versioduo/wave/hardware/README.md

# wave
🔊 MIDI Wave Synthesizer with Class-D Amplifier 

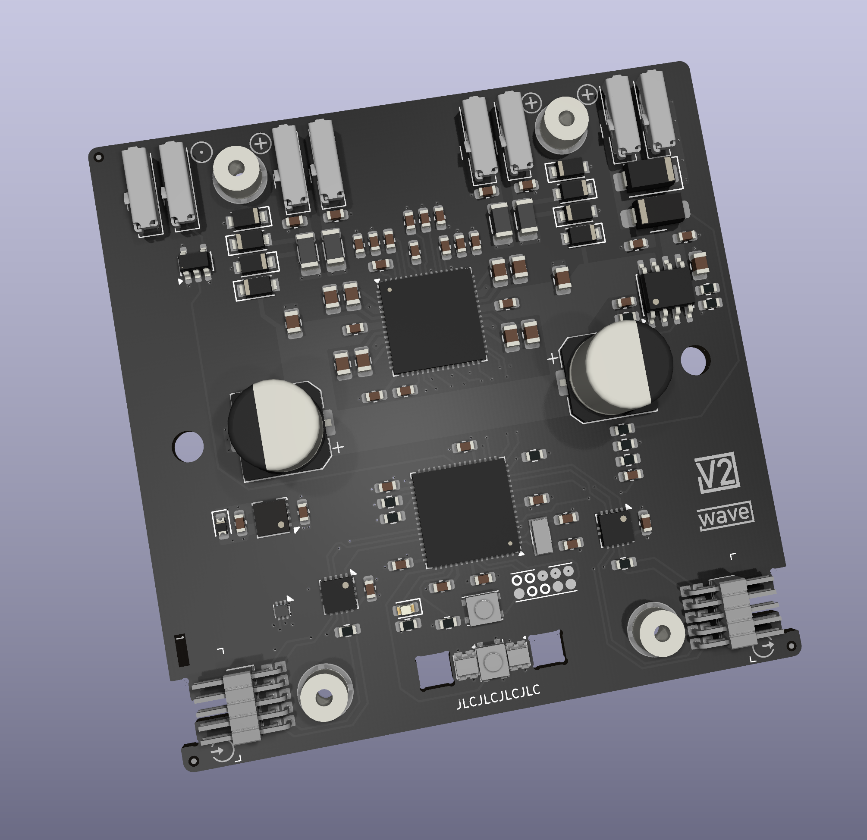
[picture p1: hardware/wave-board.png]
wave


## Schematic
[PDF](wave.pdf)

## Bill Of Materials
[Interactive BOM](https://html-preview.github.io/?url=https://github.com/versioduo/wave/main/hardware/wave-bom.html)

# Copying
Anyone can use this public domain work without having to seek authorisation, no one can ever own it.
