versioduo/wave/hardware/wave.pdf

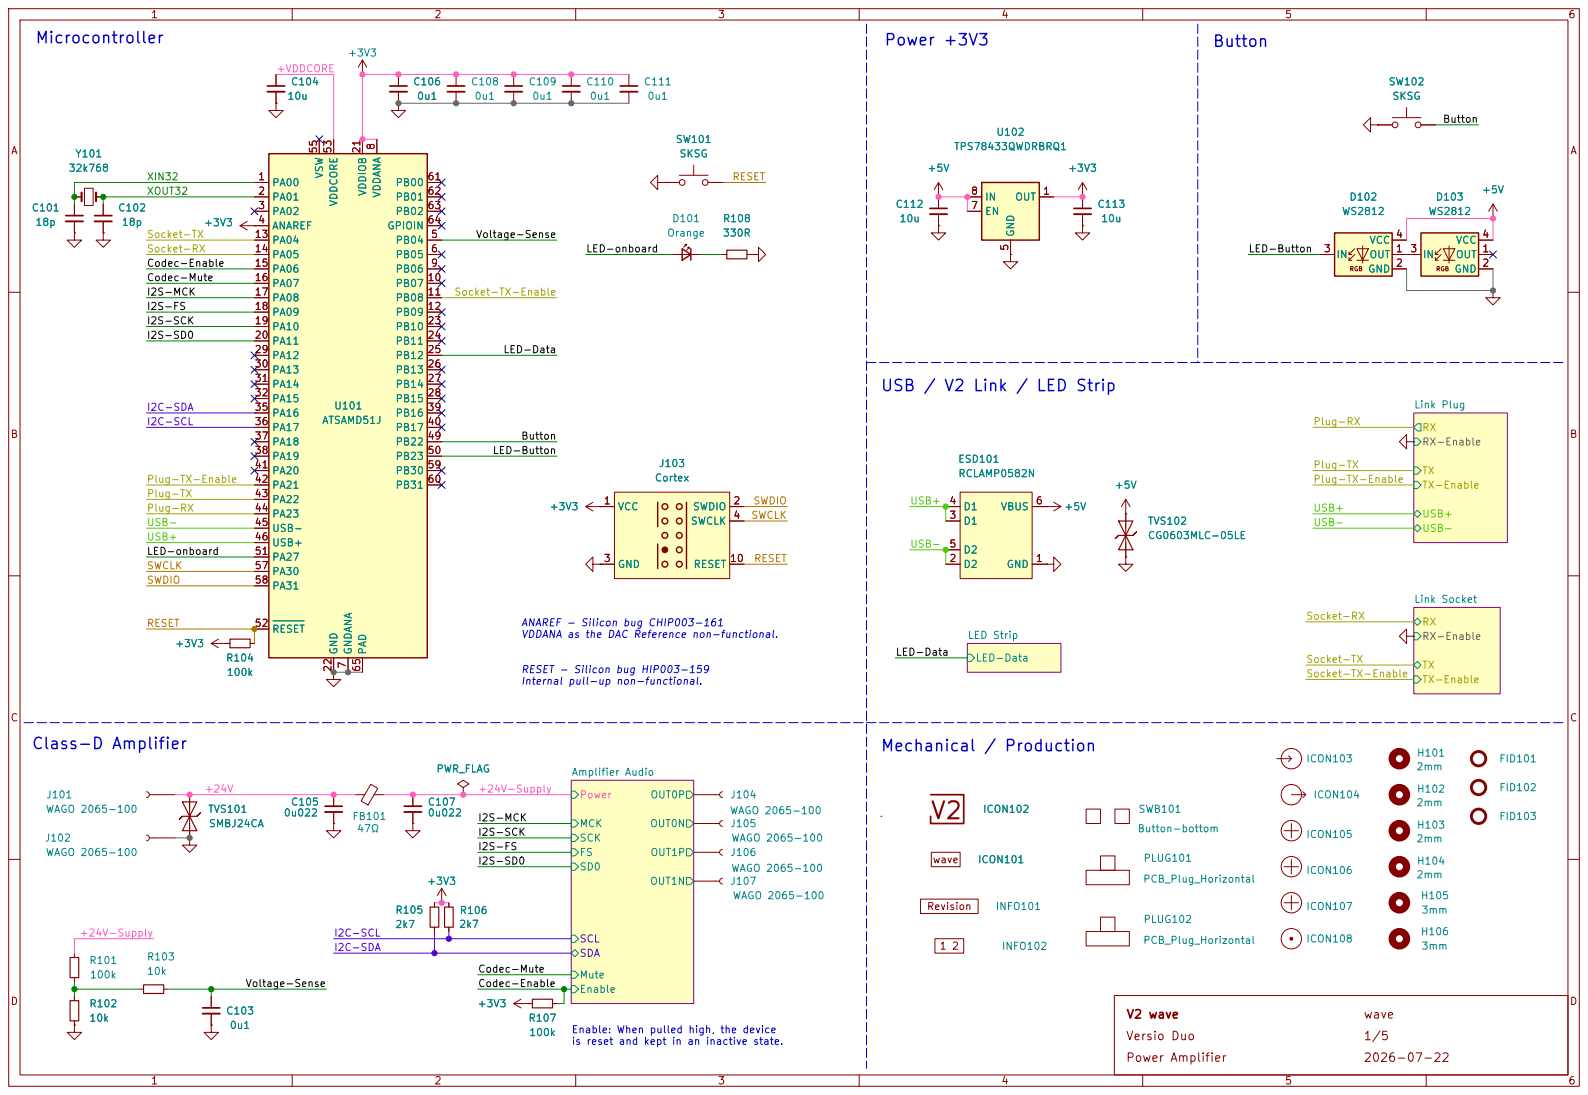
[picture p3: page 1]

VDDANA as the DAC Reference non-functional. Microcontroller

Voltage-Sense Socket-TX-Enable

Socket-RX Codec-Enable

USB / V2 Link / LED Strip

LED-Button Button Plug-TX-Enable

RESET - Silicon bug HIP003-159
Internal pull-up non-functional.

I2S-SCK +24V-Supply
Enable Mute SCL FS

Enable: When pulled high, the device

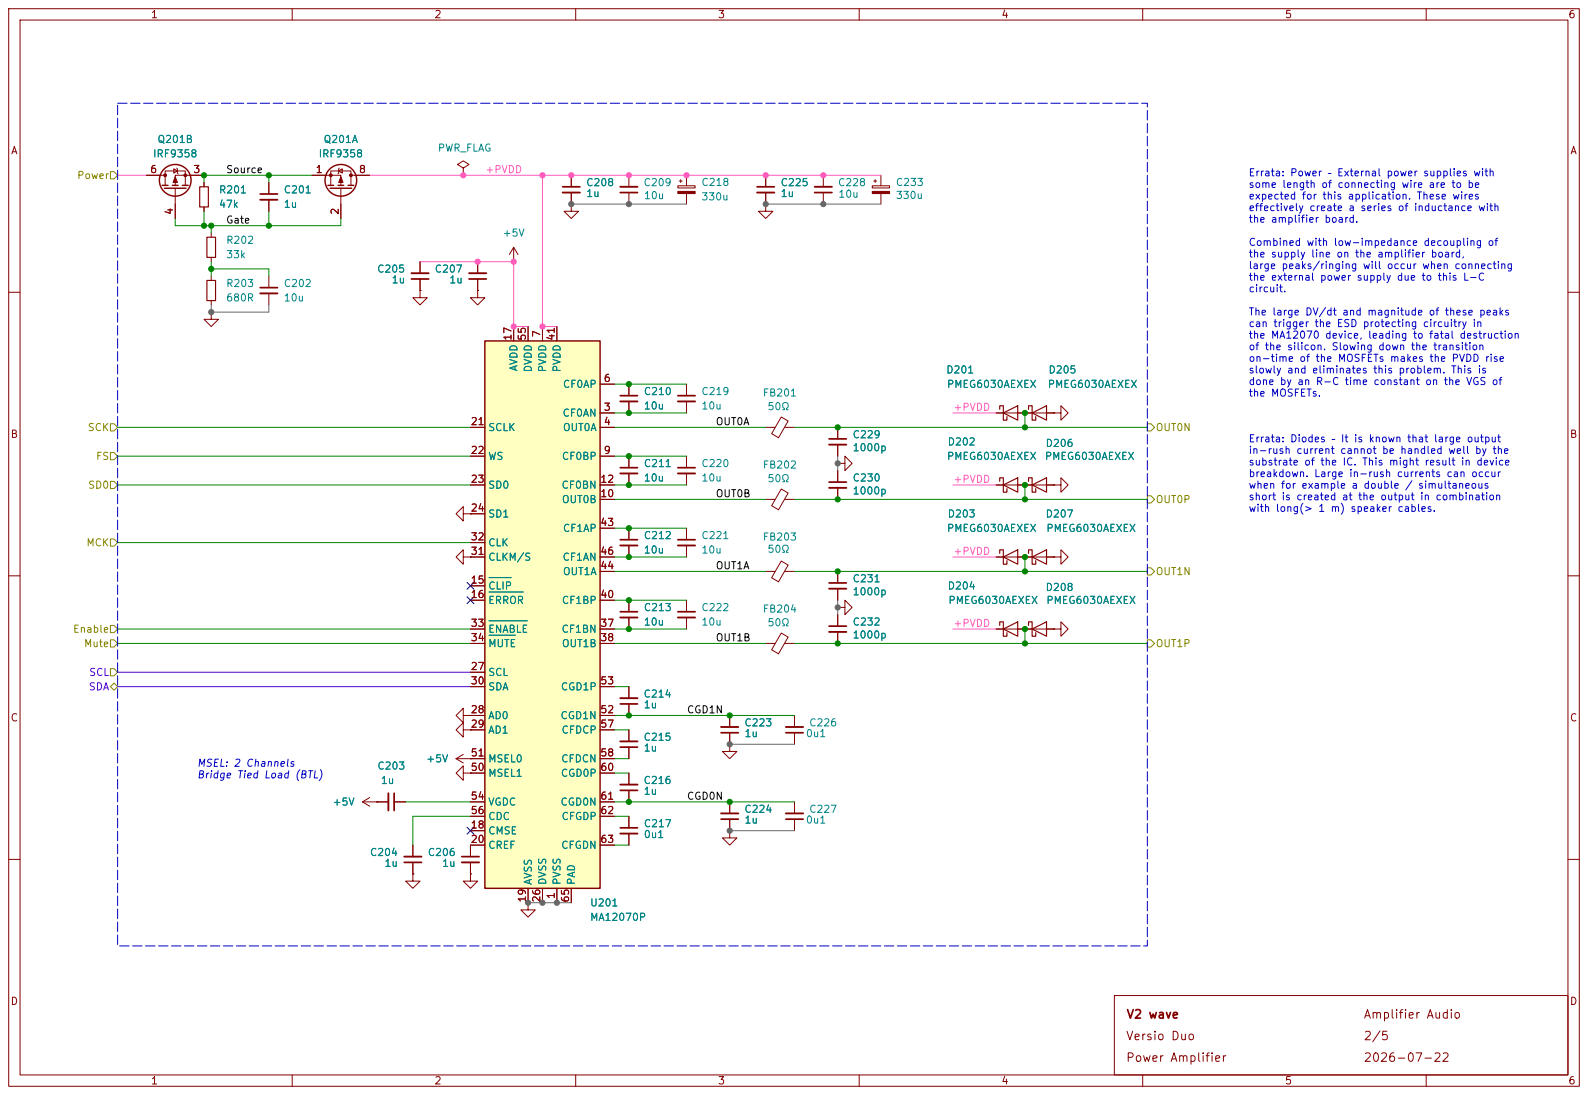
[picture p4: page 2]

Errata: Power – External power supplies with
some length of connecting wire are to be
expected for this application. These wires effectively create a series of inductance with

the amplifier board. Combined with low-impedance decoupling of

the supply line on the amplifier board,
large peaks/ringing will occur when connecting
the external power supply due to this L-C
circuit. The large DV/dt and magnitude of these peaks can trigger the ESD protecting circuitry in

the MA12070 device, leading to fatal destruction
of the silicon. Slowing down the transition
on-time of the MOSFETs makes the PVDD rise
slowly and eliminates this problem. This is done by an R-C time constant on the VGS of

the MOSFETs. Errata: Diodes – It is known that large output

in-rush current cannot be handled well by the
substrate of the IC. This might result in device breakdown. Large in-rush currents can occur when for example a double / simultaneous

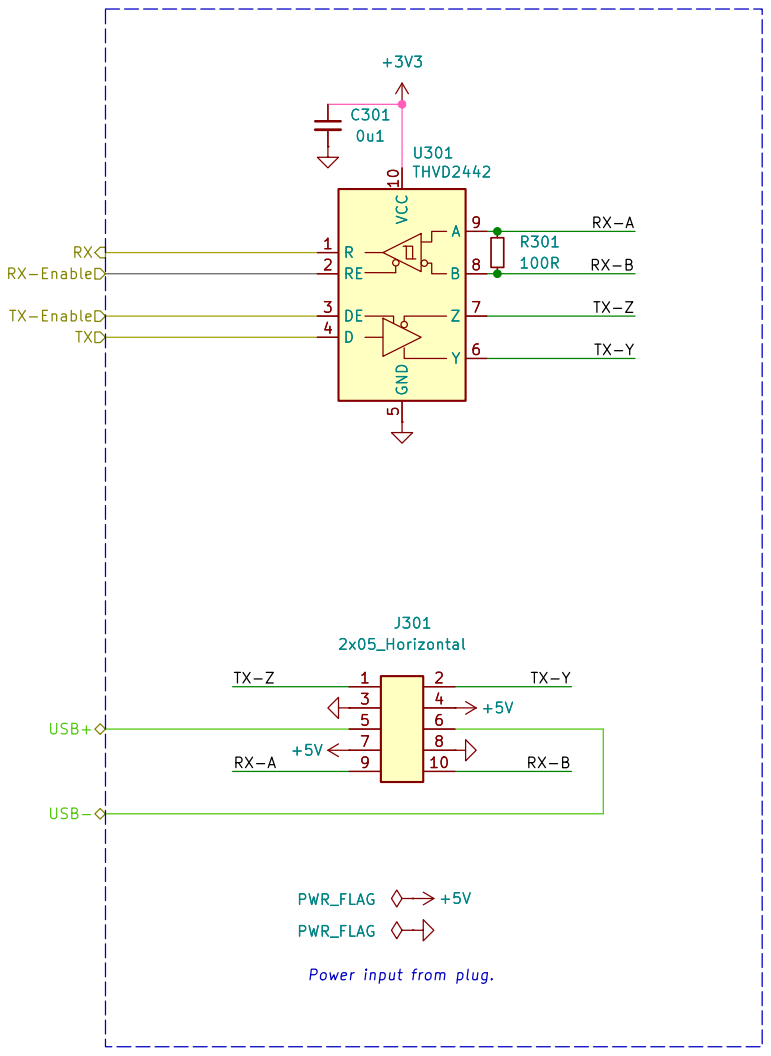
[picture p5: page 3]

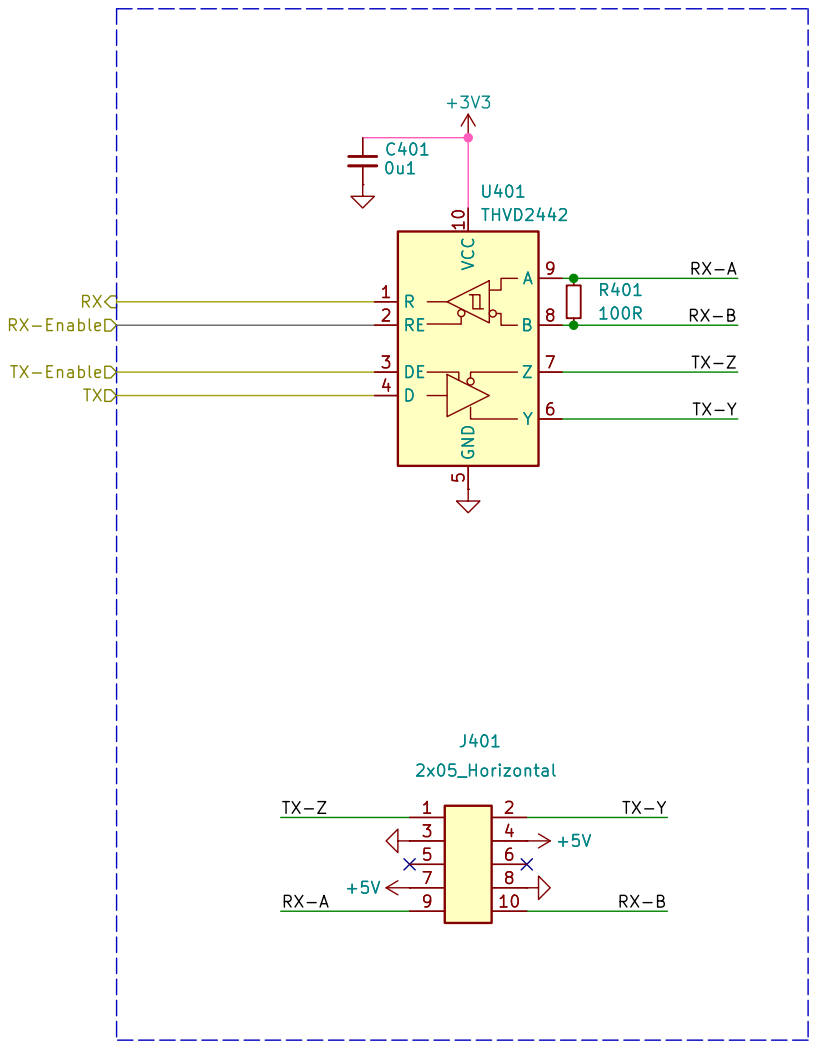
[picture p6: page 4]

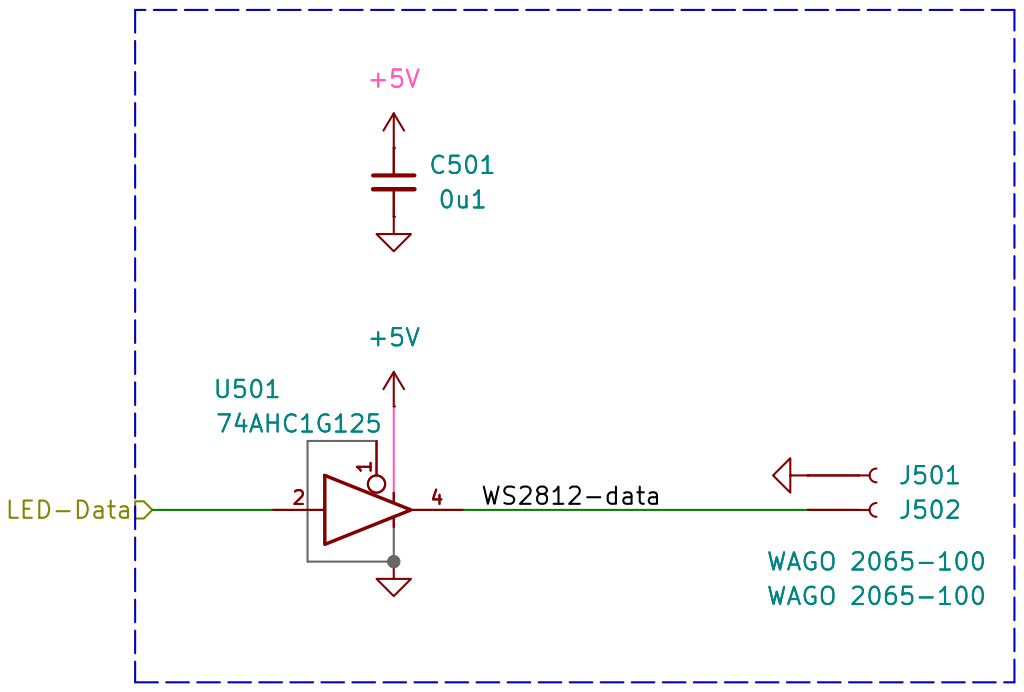
[picture p7: page 5]
