versioduo/wave/hardware/wave.kicad_pcb

## KiCad design hardware/wave.kicad_pcb (2026-07-22)

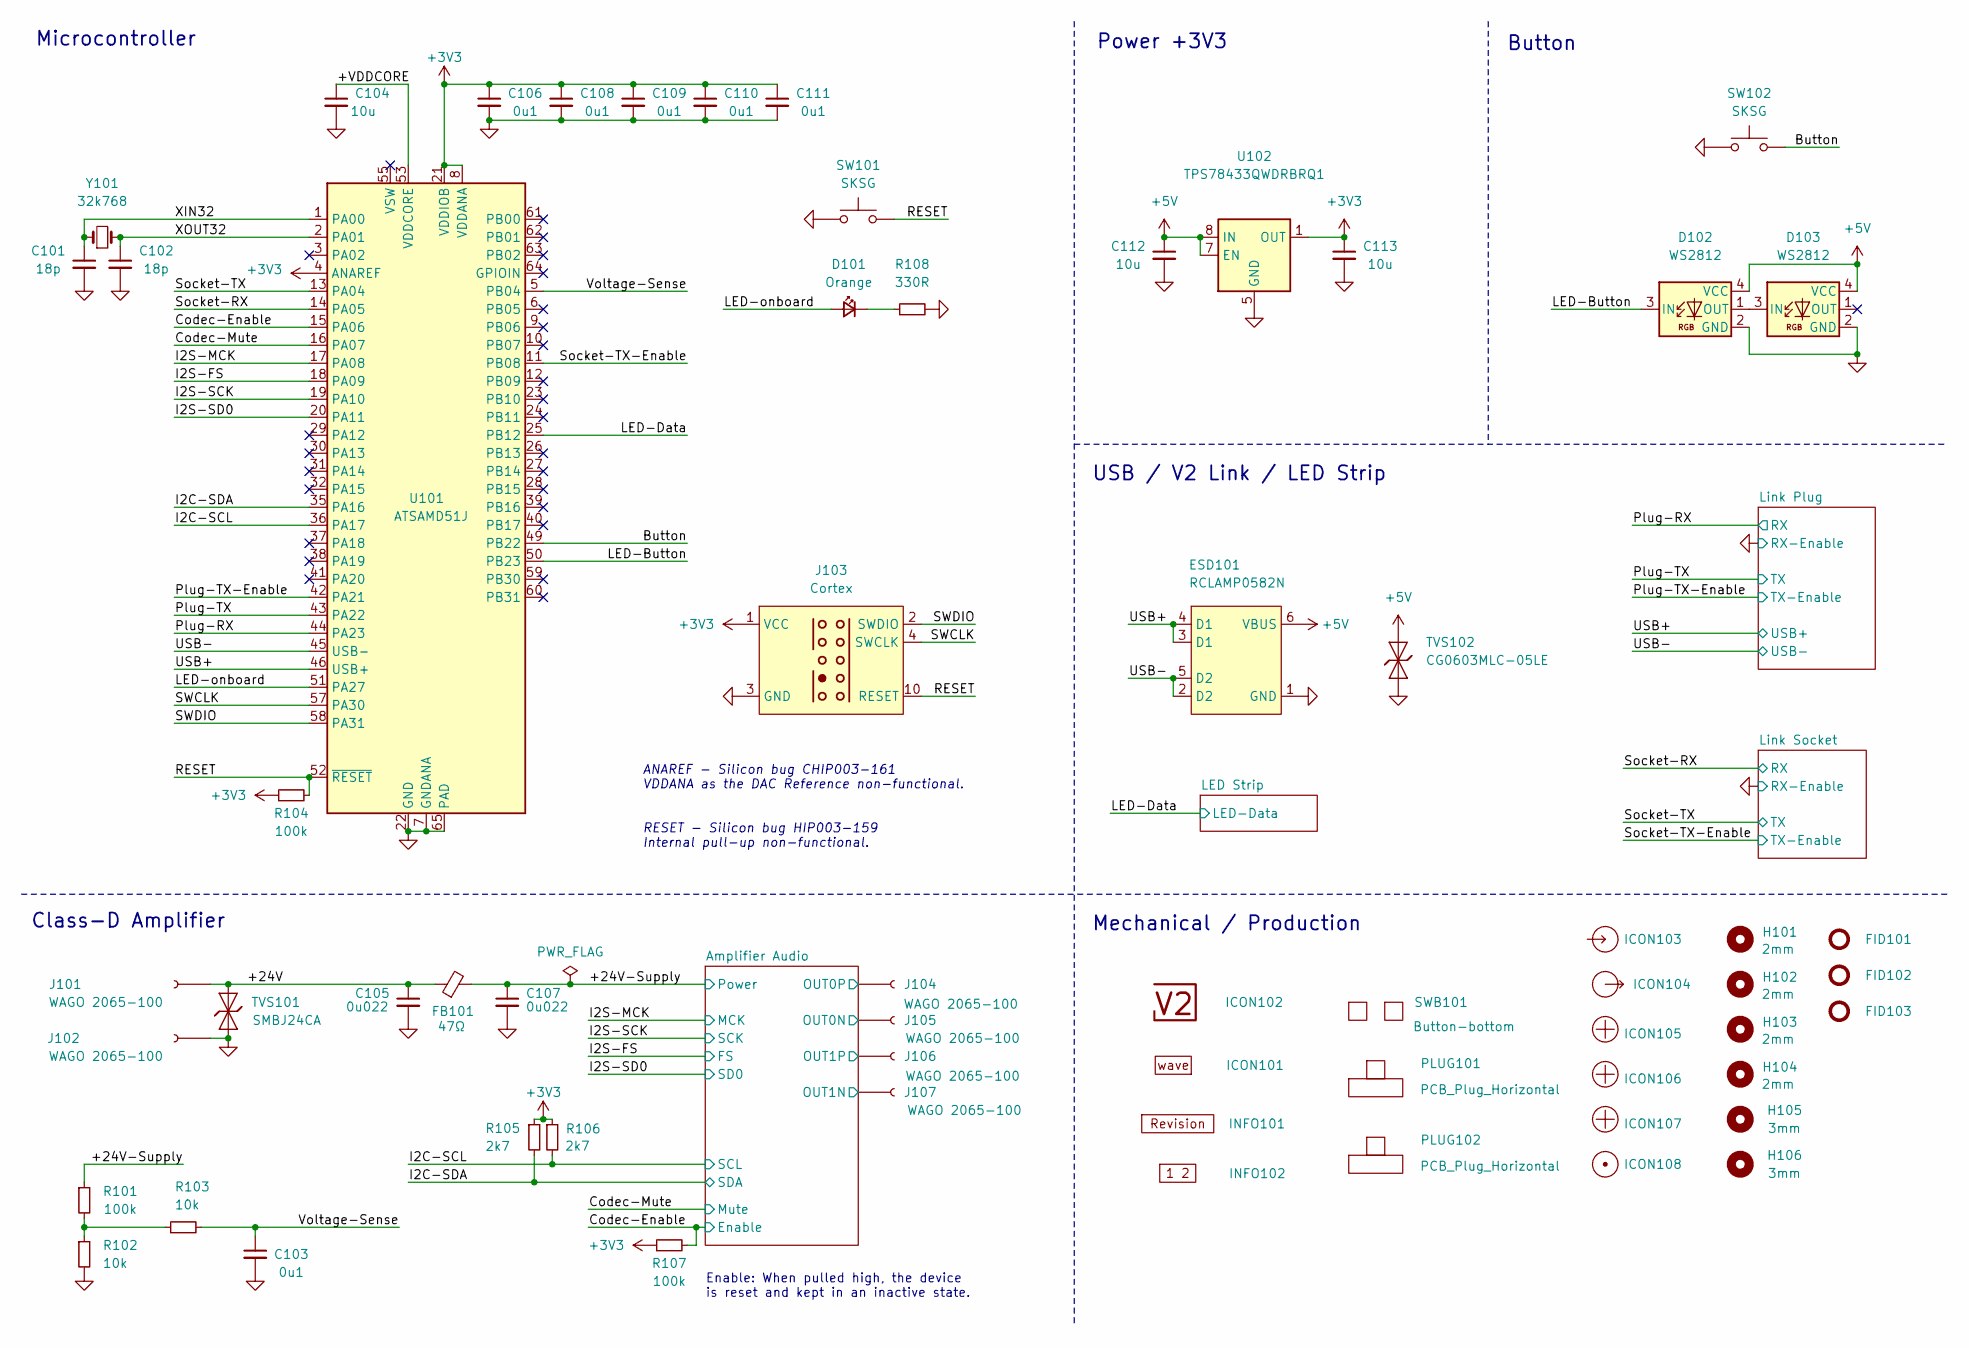
[picture p8: schematic wave.kicad_sch, V2 wave]

Parts:
C101, C102: 18p; C_1608; Rating 50V; Mouser 810-CGA3E2C0G1H180J
C103, C106, C108, C109, C110, C111: 0u1; C_1608; Rating 50V; Mouser 810-CGA3E2X7R1H104MA
C104: 10u; C_1608; Rating 10V; Mouser 810-C1608X6S1A106M
C105, C107: 0u022; C_1608; Rating 50V; Mouser 603-CC603KPX7R9BB223
C112, C113: 10u; C_2012; Rating 25V; Mouser 810-C2012X5R1E106K
D101: Orange; LED_1608; Rating 605nm; Mouser 755-SML-D12D1WT86
D102, D103: WS2812; WS2812-2020; Rating 15mA; LCSC C965555
ESD101: RCLAMP0582N; SLP1210N6; Rating 20kV; Mouser 947-RCLAMP0582N.TCT
FB101: 47Ω; L_3.1x5.1; Rating 5A; Mouser 623-2743019447LF
FID101, FID102, FID103: Fiducial_Paste; Fiducial_0.5mm_Mask1mm_Paste
H101, H102, H103, H104: 2mm; MountingHole_2mm
H105, H106: 3mm; MountingHole_3mm
ICON101: Board_wave; Board_wave_Small
ICON102: V2-logo; Logo_Small
ICON103: Arrow_In
ICON104: Arrow_Out
ICON105, ICON106, ICON107: Plus; Plus_Small
ICON108: Dot; Dot_Small
INFO101: Revision
INFO102: Layer_Numbers-4
J101, J102, J104, J105, J106, J107: WAGO 2065-100; 2065-100; Rating 9A
J103: Cortex
PLUG101, PLUG102: PCB_Plug_Horizontal
R101, R104, R107: 100k; R_1608; Rating 100mW; Mouser 71-CRCW0603100KFKEAC
R102, R103: 10k; R_1608; Rating 100mW; Mouser 71-CRCW060310K0FKEAC
R105, R106: 2k7; R_1608; Rating 100mW; Mouser 71-CRCW06032K70FKEAC
R108: 330R; R_1608; Rating 100mW; Mouser 71-CRCW0603330RFKEAC
SW101, SW102: SKSG; Rating 1.6N; Mouser 688-SKSGACE010
SWB101: Button-bottom; PCB_Button-bottom
TVS101: SMBJ24CA; D_SMB; Rating 24V; Mouser 652-SMBJ24CA-Q
TVS102: CG0603MLC-05LE; D_1608; Rating 5V; Mouser 652-CG0603MLC-05LE
U101: ATSAMD51J; QFN-64-1EP_9x9mm_P0.5mm_EP4.8x4.8mm_ThermalVias; Rating Cortex-M4F; Mouser 556-ATSAMD51J19AMU
U102: TPS78433QWDRBRQ1; VSON-8-1_3x3mm_P0.65_EP1.65x2.4mm; Rating 300mA; Mouser 595-TPS78433QWDRBRQ1
Y101: 32k768; Crystal_SMD_3215-2Pin_3.2x1.5mm; Rating 10ppm; Mouser 815-ABS0716632.768KT

Connections:
+3V3: C106.1, C108.1, C109.1, C110.1, C111.1, C113.1, J103.1 (VCC), R104.1, R105.1, R106.1, R107.1, U101.4 (ANAREF), U101.8 (VDDANA), U101.21 (VDDIOB), U101.34 (VDDIO), U101.48 (VDDIO), U101.56 (VDDIO), U102.1 (OUT); also elsewhere on the board
+5V: C112.1, D102.4 (VCC), D103.4 (VCC), ESD101.6 (VBUS), TVS102.2 (A), U102.7 (EN), U102.8 (IN); also elsewhere on the board
/+24V: C105.1, FB101.1, J101.1, TVS101.2 (A)
/+24V-Supply: C107.1, FB101.2, R101.1; also elsewhere on the board
/+VDDCORE: C104.1, U101.53 (VDDCORE)
/Amplifier Audio/OUT0N: J105.1; also elsewhere on the board
/Amplifier Audio/OUT0P: J104.1; also elsewhere on the board
/Amplifier Audio/OUT1N: J107.1; also elsewhere on the board
/Amplifier Audio/OUT1P: J106.1; also elsewhere on the board
/Button: SW102.2, U101.49 (PB22)
/Codec-Enable: R107.2, U101.15 (PA06); also elsewhere on the board
/Codec-Mute: U101.16 (PA07); also elsewhere on the board
/I2C-SCL: R106.2, U101.36 (PA17); also elsewhere on the board
/I2C-SDA: R105.2, U101.35 (PA16); also elsewhere on the board
/I2S-FS: U101.18 (PA09); also elsewhere on the board
/I2S-MCK: U101.17 (PA08); also elsewhere on the board
/I2S-SCK: U101.19 (PA10); also elsewhere on the board
/I2S-SD0: U101.20 (PA11); also elsewhere on the board
/LED-Button: D102.3 (IN), U101.50 (PB23)
/LED-Data: U101.25 (PB12); also elsewhere on the board
/LED-onboard: D101.2 (A), U101.51 (PA27)
/Plug-RX: U101.44 (PA23); also elsewhere on the board
/Plug-TX: U101.43 (PA22); also elsewhere on the board
/Plug-TX-Enable: U101.42 (PA21); also elsewhere on the board
/RESET: J103.10 (RESET), R104.2, SW101.2, U101.52 (~RESET)
/SWCLK: J103.4 (SWCLK), U101.57 (PA30)
/SWDIO: J103.2 (SWDIO), U101.58 (PA31)
/Socket-RX: U101.14 (PA05); also elsewhere on the board
/Socket-TX: U101.13 (PA04); also elsewhere on the board
/Socket-TX-Enable: U101.11 (PB08); also elsewhere on the board
/USB+: ESD101.3 (D1), ESD101.4 (D1), U101.46 (USB+); also elsewhere on the board
/USB-: ESD101.2 (D2), ESD101.5 (D2), U101.45 (USB-); also elsewhere on the board
/Voltage-Sense: C103.1, R103.2, U101.5 (PB04)
/XIN32: C101.1, U101.1 (PA00), Y101.1
/XOUT32: C102.1, U101.2 (PA01), Y101.2
GND: C101.2, C102.2, C103.2, C104.2, C105.2, C106.2, C107.2, C108.2, C109.2, C110.2, C111.2, C112.2, C113.2, D102.2 (GND), D103.2 (GND), ESD101.1 (GND), J102.1, J103.3 (GND), J103.5 (GND), R102.2, R108.2, SW101.1, SW102.1, TVS101.1 (K), TVS102.1 (K), U101.7 (GNDANA), U101.22 (GND), U101.33 (GND), U101.47 (GND), U101.54 (GND), U101.65 (PAD), U102.5 (GND), U102.9 (GND); also elsewhere on the board
unnamed: D101.1 (K), R108.1
unnamed: D102.1 (OUT), D103.3 (IN)
unnamed: R101.2, R102.1, R103.1

Notes on the sheet:
 ANAREF - Silicon bug CHIP003-161 VDDANA as the DAC Reference non-functional.
RESET -  Silicon bug HIP003-159 Internal pull-up non-functional.
Button
USB / V2 Link / LED Strip
Mechanical / Production
Power +3V3
Enable: When pulled high, the device is reset and kept in an inactive state.
Microcontroller
Class-D Amplifier

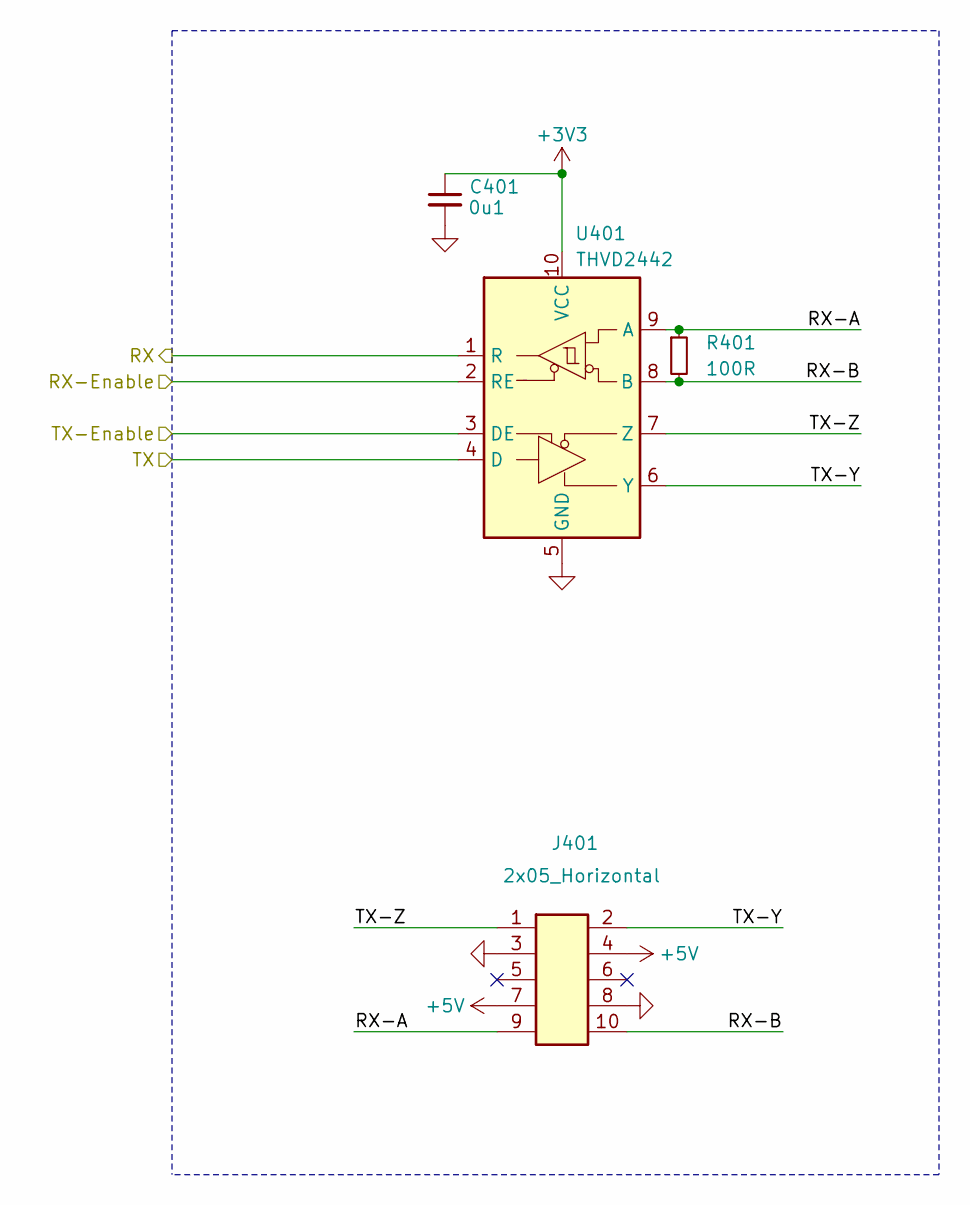
[picture p9: schematic LinkSocket.kicad_sch, V2 wave]

Parts:
C401: 0u1; C_1608; Rating 50V; Mouser 810-CGA3E2X7R1H104MA
J401: 2x05_Horizontal; PinHeader_2x05_P1.27mm_Horizontal; Rating 1A; Mouser 649-200211120001T4LF
R401: 100R; R_1608; Rating 330mW; Mouser 71-CRCW0603100RFKEAH
U401: THVD2442; VSON-10-4-1EP_3x3mm_P0.5mm_EP1.65x2.4mm_ThermalVias; Rating 20Mbps; Mouser 595-THVD2442DRCR

Connections:
+3V3: C401.1, U401.10 (VCC); also elsewhere on the board
+5V: J401.4, J401.7; also elsewhere on the board
/Link Socket/RX-A: J401.9, R401.1, U401.9 (A)
/Link Socket/RX-B: J401.10, R401.2, U401.8 (B)
/Link Socket/TX-Y: J401.2, U401.6 (Y)
/Link Socket/TX-Z: J401.1, U401.7 (Z)
/Socket-RX: U401.1 (R); also elsewhere on the board
/Socket-TX: U401.4 (D); also elsewhere on the board
/Socket-TX-Enable: U401.3 (DE); also elsewhere on the board
GND: C401.2, J401.3, J401.8, U401.2 (RE), U401.5 (GND), U401.11 (GND); also elsewhere on the board

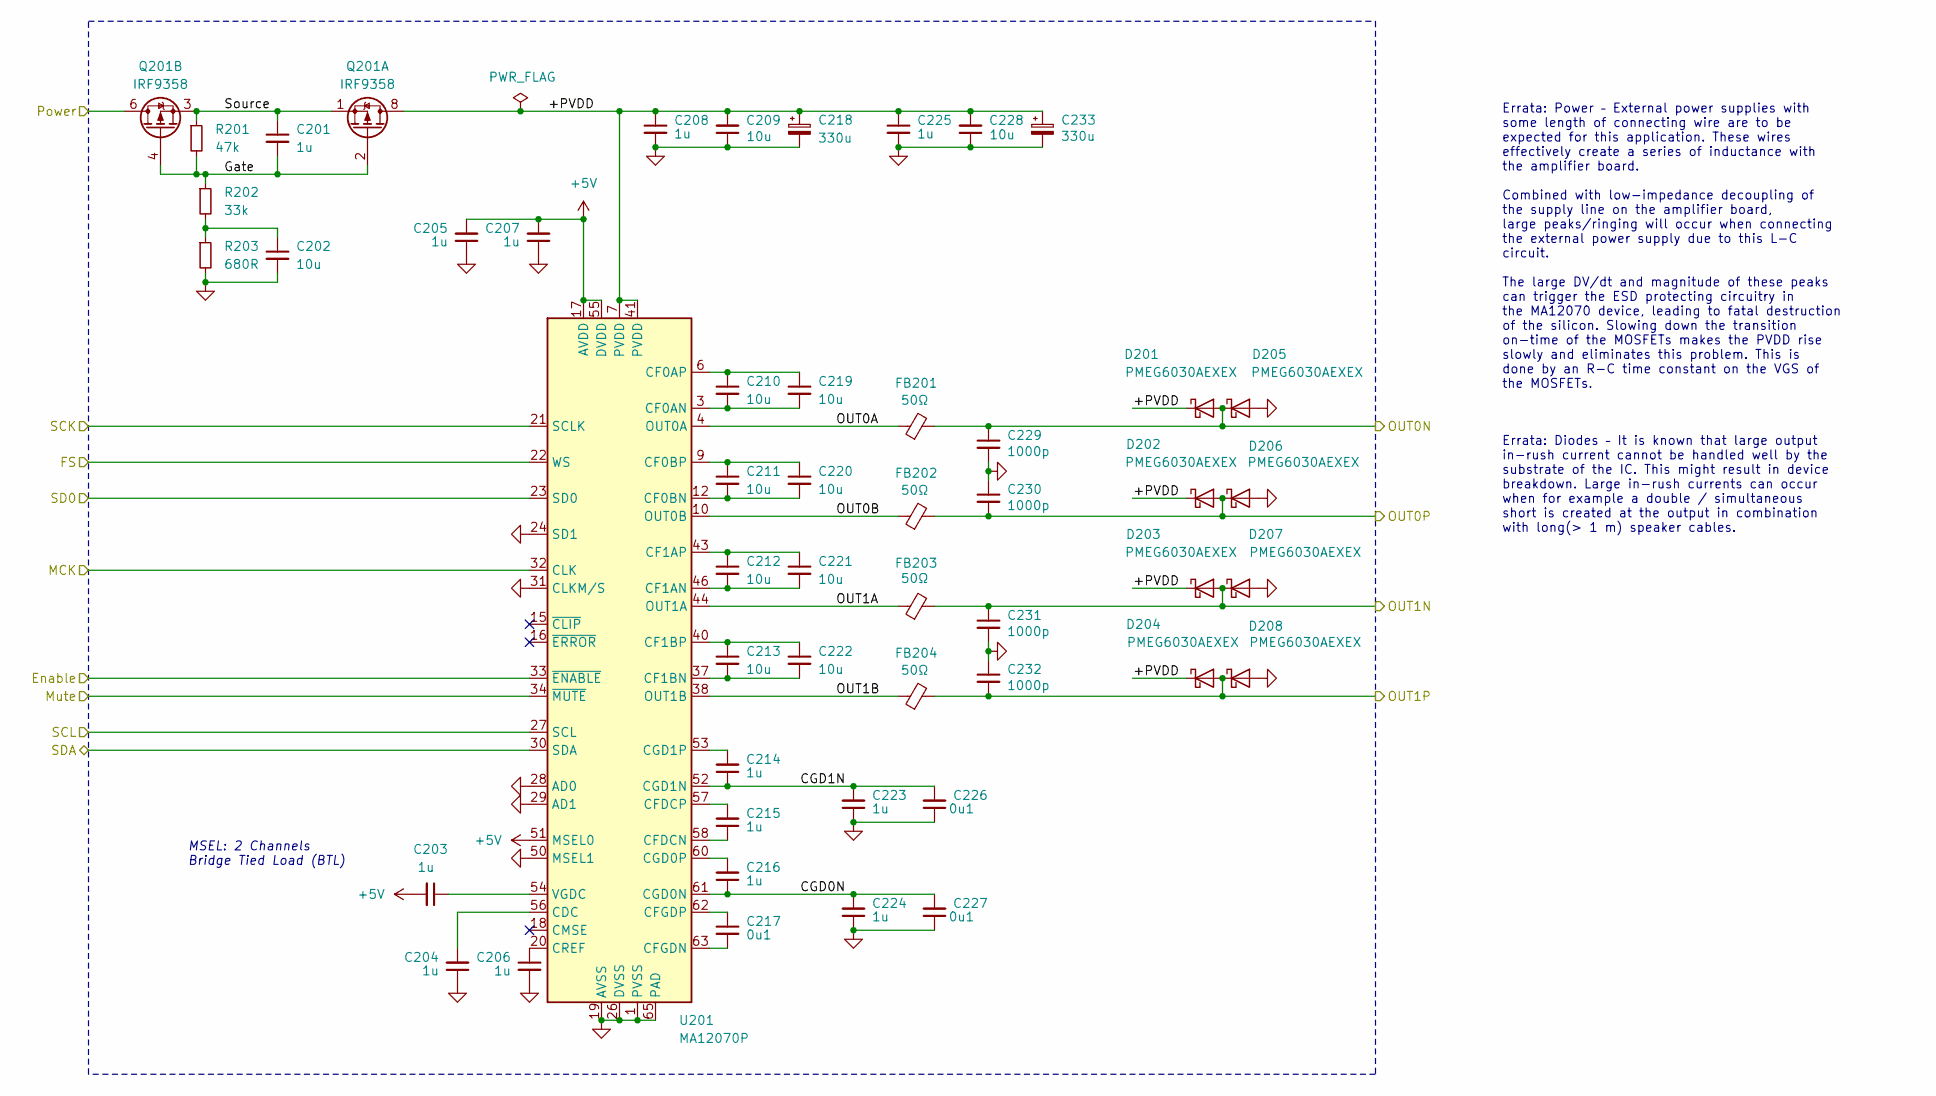
[picture p10: schematic AmplifierAudio.kicad_sch, V2 wave]

Parts:
C201, C203, C204, C205, C206, C207, C208, C214, C215, C216, C223, C224, C225: 1u; C_1608; Rating 50V; Mouser 810-CGA3E3X7R1H105K0
C202, C209, C210, C211, C212, C213, C219, C220, C221, C222, C228: 10u; C_1608; Rating 10V; Mouser 810-C1608X6S1A106M
C217, C226, C227: 0u1; C_1608; Rating 50V; Mouser 810-CGA3E2X7R1H104MA
C218, C233: 330u; CP_Elec_8x10; Rating 35V; Mouser 667-EEE-FT1V331GP
C229, C230, C231, C232: 1000p; C_1608; Rating 50V; Mouser 810-C1608C0G1H102J
D201, D202, D203, D204, D205, D206, D207, D208: PMEG6030AEXEX; D_SOD-123HP; Rating 60V; Mouser 771-PMEG6030AEXEX
FB201, FB202, FB203, FB204: 50Ω; L_1206; Rating 6A; Mouser 623-2512065007Y6
Q201: IRF9358; SOIC-8_3.9x4.9mm_P1.27mm; Rating 30V; Mouser 942-IRF9358TRPBF
R201: 47k; R_1608; Rating 250mW; Mouser 71-RCS060347K0FKEA
R202: 33k; R_1608; Rating 330mW; Mouser 71- 71-CRCW060333K0FKEAH
R203: 680R; R_1608; Rating 250mW; Mouser 71-RCS0603680RFKEA
U201: MA12070P; QFN-64-1EP_9x9mm_P0.5mm_EP6x6mm_ThermalVias; Rating 30W; Mouser 726-MA12070PXUMA1

Connections:
+5V: C203.2, C205.2, C207.2, U201.17 (AVDD), U201.51 (MSEL0), U201.55 (DVDD); also elsewhere on the board
/+24V-Supply: Q201.5 (D2), Q201.6 (D2); also elsewhere on the board
/Amplifier Audio/+PVDD: C208.1, C209.2, C218.1, C225.1, C228.2, C233.1, D201.1 (K), D202.1 (K), D203.1 (K), D204.1 (K), Q201.7 (D1), Q201.8 (D1), U201.7 (PVDD), U201.8 (PVDD), U201.41 (PVDD), U201.42 (PVDD)
/Amplifier Audio/CGD0N: C216.1, C224.2, C227.2, U201.61 (CGD0N)
/Amplifier Audio/CGD1N: C214.1, C223.2, C226.2, U201.52 (CGD1N)
/Amplifier Audio/Gate: C201.2, Q201.2 (G1), Q201.4 (G2), R201.2, R202.1
/Amplifier Audio/OUT0A: FB201.1, U201.4 (OUT0A), U201.5 (OUT0A)
/Amplifier Audio/OUT0B: FB202.1, U201.10 (OUT0B), U201.11 (OUT0B)
/Amplifier Audio/OUT0N: C229.1, D201.2 (A), D205.1 (K), FB201.2; also elsewhere on the board
/Amplifier Audio/OUT0P: C230.2, D202.2 (A), D206.1 (K), FB202.2; also elsewhere on the board
/Amplifier Audio/OUT1A: FB203.1, U201.44 (OUT1A), U201.45 (OUT1A)
/Amplifier Audio/OUT1B: FB204.1, U201.38 (OUT1B), U201.39 (OUT1B)
/Amplifier Audio/OUT1N: C231.1, D203.2 (A), D207.1 (K), FB203.2; also elsewhere on the board
/Amplifier Audio/OUT1P: C232.2, D204.2 (A), D208.1 (K), FB204.2; also elsewhere on the board
/Amplifier Audio/Source: C201.1, Q201.1 (S1), Q201.3 (S2), R201.1
/Codec-Enable: U201.33 (~ENABLE); also elsewhere on the board
/Codec-Mute: U201.34 (~MUTE); also elsewhere on the board
/I2C-SCL: U201.27 (SCL); also elsewhere on the board
/I2C-SDA: U201.30 (SDA); also elsewhere on the board
/I2S-FS: U201.22 (WS); also elsewhere on the board
/I2S-MCK: U201.32 (CLK); also elsewhere on the board
/I2S-SCK: U201.21 (SCLK); also elsewhere on the board
/I2S-SD0: U201.23 (SD0); also elsewhere on the board
GND: C202.2, C204.1, C205.1, C206.2, C207.1, C208.2, C209.1, C218.2, C223.1, C224.1, C225.2, C226.1, C227.1, C228.1, C229.2, C230.1, C231.2, C232.1, C233.2, D205.2 (A), D206.2 (A), D207.2 (A), D208.2 (A), R203.2, U201.1 (PVSS), U201.2 (PVSS), U201.13 (PVSS), U201.14 (PVSS), U201.19 (AVSS), U201.24 (SD1), U201.25 (AVSS), U201.26 (DVSS), U201.28 (AD0), U201.29 (AD1), U201.31 (CLKM/S), U201.35 (PVSS), U201.36 (PVSS), U201.47 (PVSS), U201.48 (PVSS), U201.50 (MSEL1), U201.59 (DVSS), U201.65 (PAD); also elsewhere on the board
unnamed: C202.1, R202.2, R203.1
unnamed: C204.2, U201.56 (CDC)
unnamed: C210.2, C219.2, U201.3 (CF0AN)
unnamed: C210.1, C219.1, U201.6 (CF0AP)
unnamed: C211.2, C220.2, U201.12 (CF0BN)
unnamed: C211.1, C220.1, U201.9 (CF0BP)
unnamed: C212.2, C221.2, U201.46 (CF1AN)
unnamed: C212.1, C221.1, U201.43 (CF1AP)
unnamed: C213.2, C222.2, U201.37 (CF1BN)
unnamed: C213.1, C222.1, U201.40 (CF1BP)
unnamed: C215.1, U201.58 (CFDCN)
unnamed: C215.2, U201.57 (CFDCP)
unnamed: C217.2, U201.63 (CFGDN)
unnamed: C217.1, U201.62 (CFGDP)
unnamed: C216.2, U201.60 (CGD0P)
unnamed: C214.2, U201.53 (CGD1P)
unnamed: C206.1, U201.20 (CREF)
unnamed: C203.1, U201.54 (VGDC)

Notes on the sheet:
Errata: Diodes – It is known that large output in-rush current cannot be handled well by the substrate of the IC. This might result in device breakdown. Large in-rush currents can occur when for example a double / simultaneous short is created at the output in combination with long(> 1 m) speaker c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
MSEL: 2 Channels Bridge Tied Load (BTL)
Errata: Power – External power supplies with some length of connecting wire are to be expected for this application. These wires effectively create a series of inductance with the amplifier board. Combined with low-impedance decoupling of the supply line on the amplifier board, large peaks/ringing 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

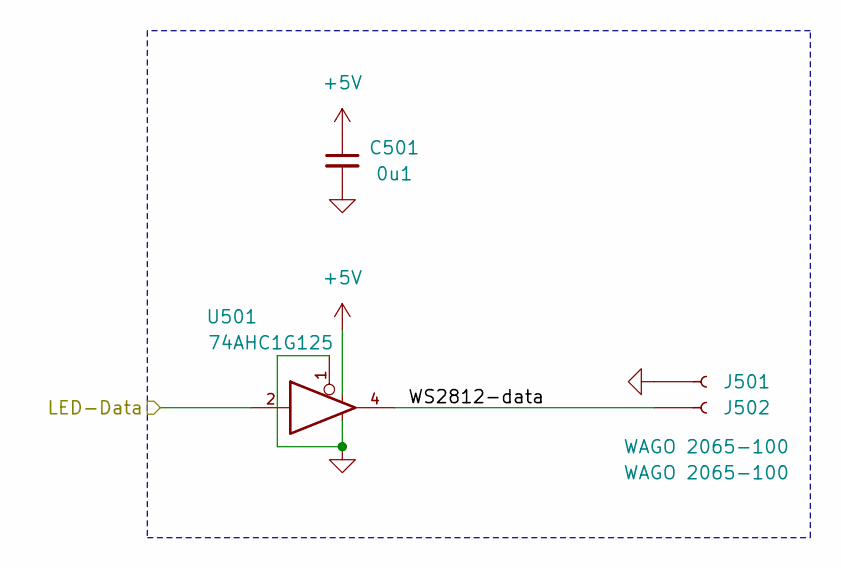
[picture p11: schematic LEDStrip.kicad_sch, V2 wave]

Parts:
C501: 0u1; C_1608; Rating 50V; Mouser 810-CGA3E2X7R1H104MA
J501, J502: WAGO 2065-100; 2065-100; Rating 9A
U501: 74AHC1G125; SOT-23-5; Rating 8mA; Mouser 595-SN74AHC1G125DBVR

Connections:
+5V: C501.1, U501.5; also elsewhere on the board
/LED Strip/WS2812-data: J502.1, U501.4
/LED-Data: U501.2; also elsewhere on the board
GND: C501.2, J501.1, U501.1, U501.3; also elsewhere on the board

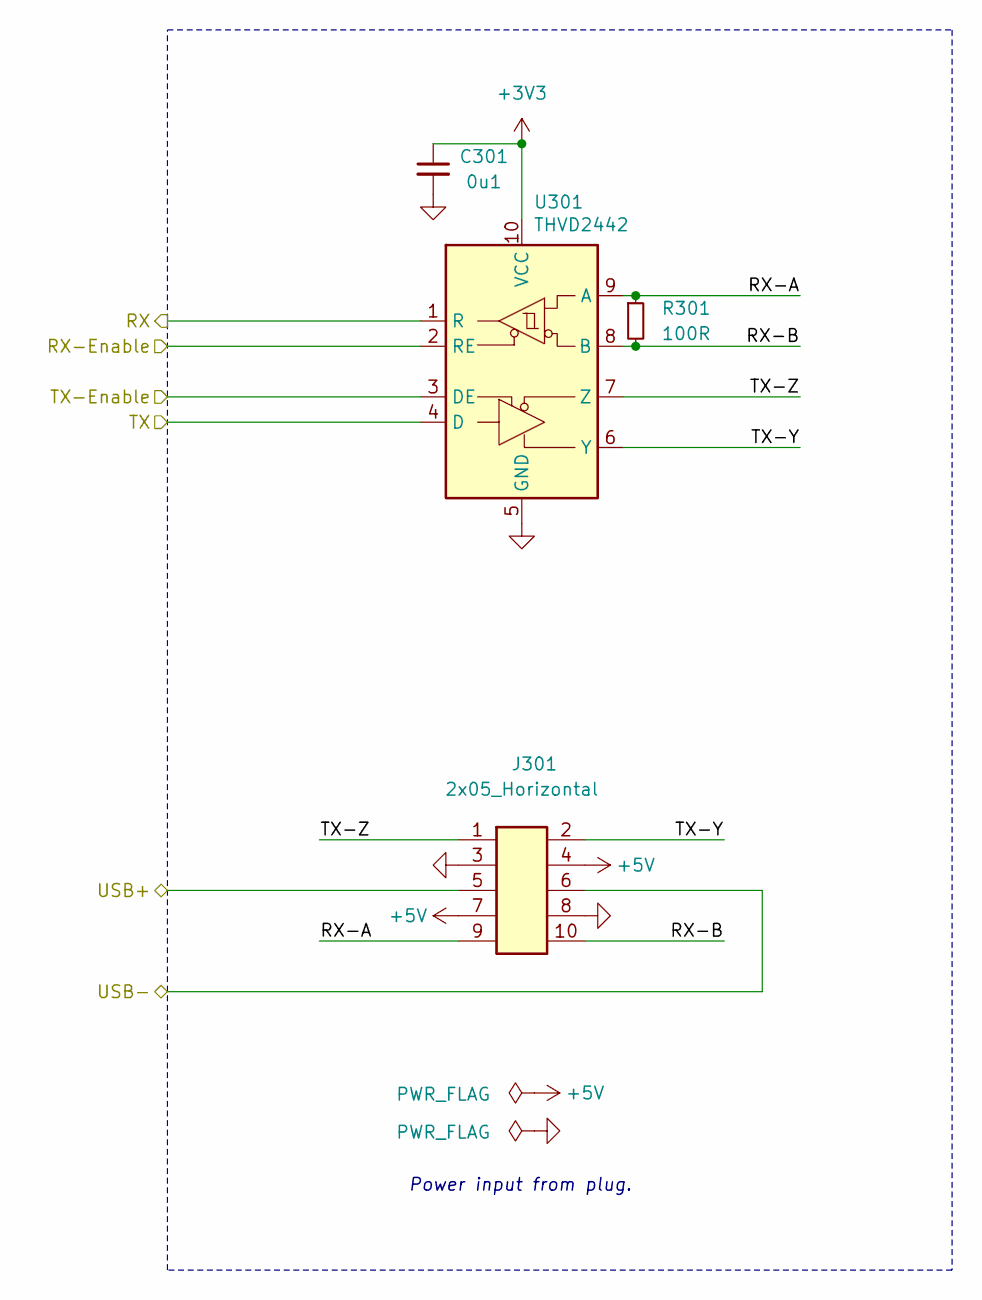
[picture p12: schematic LinkPlug.kicad_sch, V2 wave]

Parts:
C301: 0u1; C_1608; Rating 50V; Mouser 810-CGA3E2X7R1H104MA
J301: 2x05_Horizontal; PinHeader_2x05_P1.27mm_Horizontal; Rating 1A; Mouser 649-200211120001T4LF
R301: 100R; R_1608; Rating 330mW; Mouser 71-CRCW0603100RFKEAH
U301: THVD2442; VSON-10-4-1EP_3x3mm_P0.5mm_EP1.65x2.4mm_ThermalVias; Rating 20Mbps; Mouser 595-THVD2442DRCR

Connections:
+3V3: C301.1, U301.10 (VCC); also elsewhere on the board
+5V: J301.4, J301.7; also elsewhere on the board
/Link Plug/RX-A: J301.9, R301.1, U301.9 (A)
/Link Plug/RX-B: J301.10, R301.2, U301.8 (B)
/Link Plug/TX-Y: J301.2, U301.6 (Y)
/Link Plug/TX-Z: J301.1, U301.7 (Z)
/Plug-RX: U301.1 (R); also elsewhere on the board
/Plug-TX: U301.4 (D); also elsewhere on the board
/Plug-TX-Enable: U301.3 (DE); also elsewhere on the board
/USB+: J301.5; also elsewhere on the board
/USB-: J301.6; also elsewhere on the board
GND: C301.2, J301.3, J301.8, U301.2 (RE), U301.5 (GND), U301.11 (GND); also elsewhere on the board

Notes on the sheet:
Power input from plug.

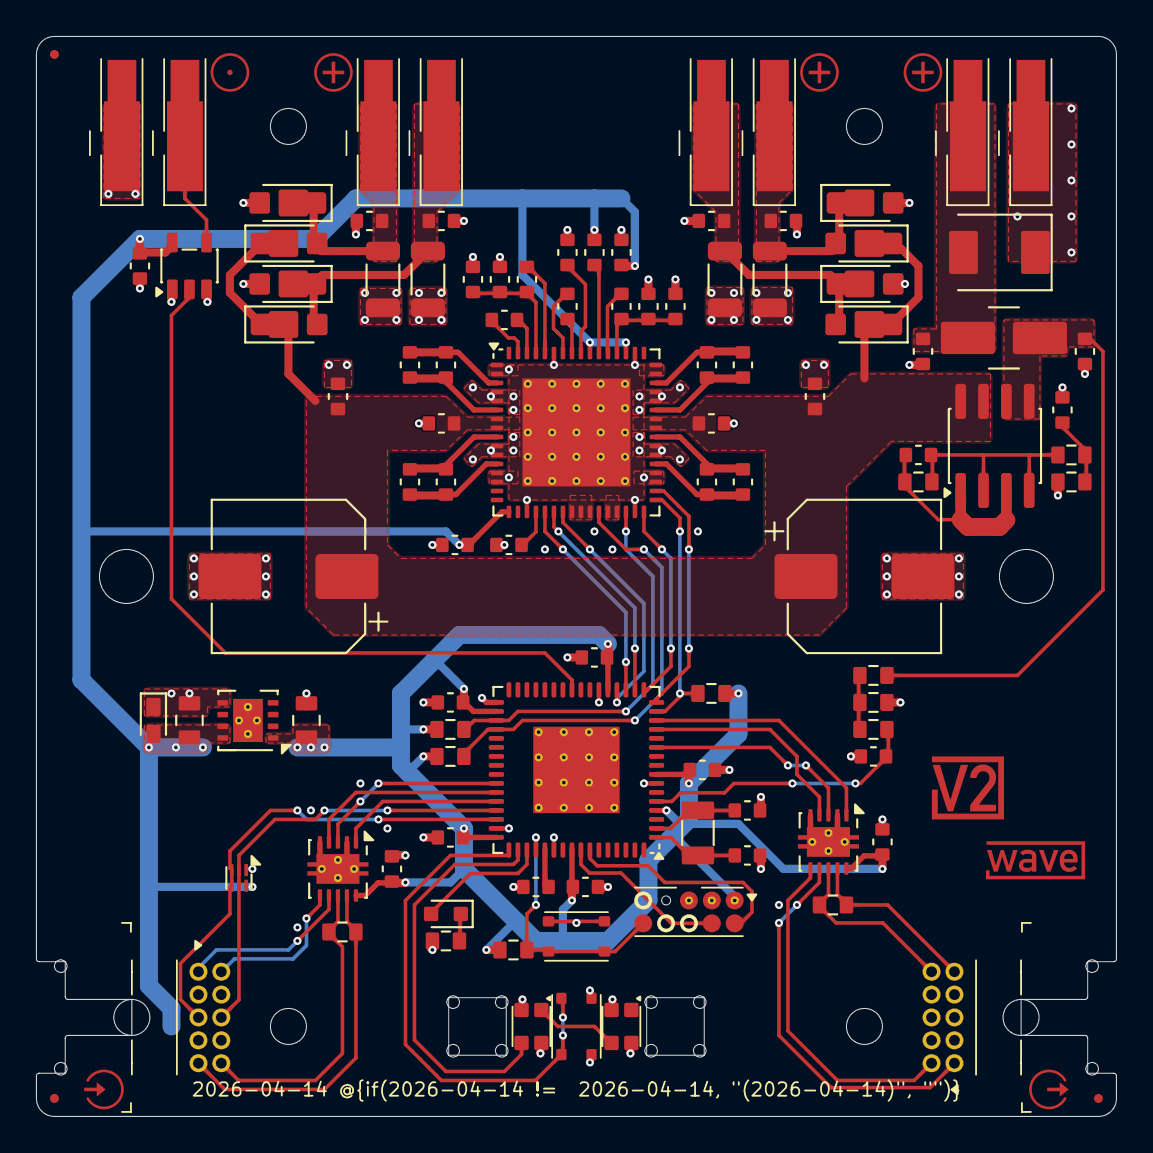
[picture p13: board wave.kicad_pcb from above]

Board: 4 copper layers, 60.0 x 60.0 mm, 124 parts (0 on the bottom side), 75 nets.
