versioduo/wave/(commit log)

2026-02-13 Replace Order_Number
    [AmplifierAudio.kicad_sch, LEDStrip.kicad_sch, LinkPlug.kicad_sch, LinkSocket.kicad_sch, wave-cover.kicad_pcb, wave-cover.kicad_sch, wave.kicad_pcb, wave.kicad_sch]
2026-02-15 Update Library
    [AmplifierAudio.kicad_sch, LEDStrip.kicad_sch, LinkPlug.kicad_sch, LinkSocket.kicad_sch, wave-cover.kicad_pcb, wave-cover.kicad_sch, wave.kicad_pcb, wave.kicad_sch]
2026-03-14 Update ESD suppressor
    [AmplifierAudio.kicad_sch, wave.kicad_pcb, wave.kicad_sch]
2026-05-11 Good Bye Imperial
    [AmplifierAudio.kicad_sch, LinkPlug.kicad_sch, LinkSocket.kicad_sch, wave.kicad_sch]
2026-07-20 Update power routing
    [AmplifierAudio.kicad_sch, LEDStrip.kicad_sch, LinkPlug.kicad_sch, LinkSocket.kicad_sch, wave.kicad_pcb, wave.kicad_sch]
2026-07-22 Update stackup
    [AmplifierAudio.kicad_sch, LEDStrip.kicad_sch, LinkPlug.kicad_sch, LinkSocket.kicad_sch, wave.kicad_pcb, wave.kicad_sch]
